txp666/MicroScope-Power/docs/open-source/hardware/挡板.step

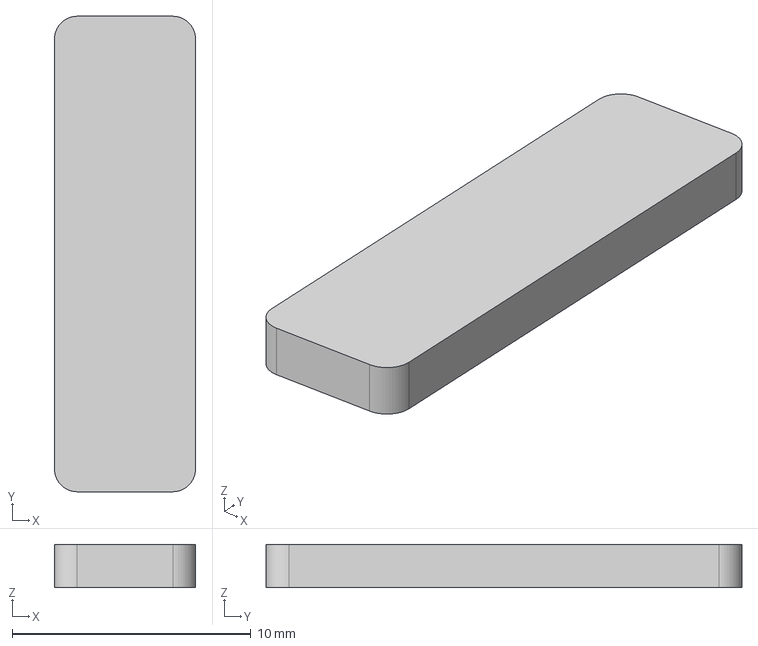
[picture p7: CAD file, 2026-10-14, last stored version]
docs/open-source/hardware/挡板.step
5.90 x 19.9 x 1.82 mm
