txp666/MicroScope-Power/docs/open-source/hardware/底壳.step

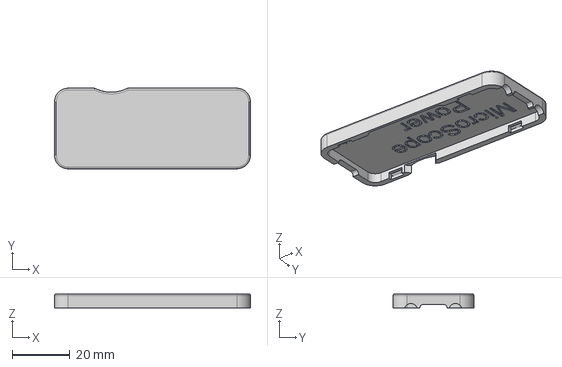
[picture p8: CAD file, 2026-10-14, last stored version]
docs/open-source/hardware/底壳.step
67.7 x 27.9 x 5.00 mm
