txp666/MicroScope-Power/docs/open-source/hardware/上盖.step

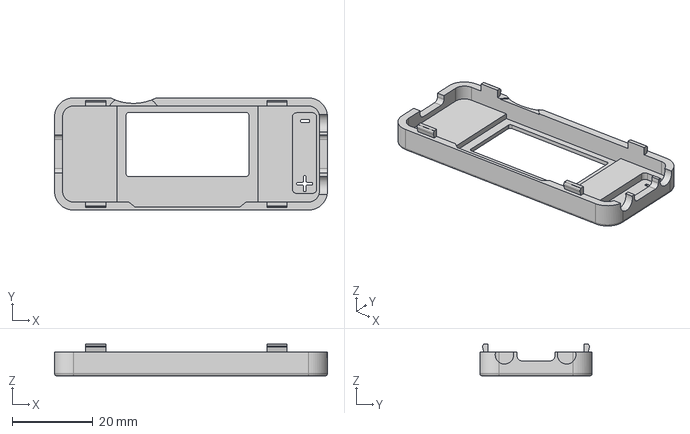
[picture p9: CAD file, 2026-10-14, last stored version]
docs/open-source/hardware/上盖.step
67.7 x 27.9 x 7.92 mm
