txp666/MicroScope-Power/docs/operation.md

# 使用说明

## 固件烧录

1. 构建固件：

   ```powershell
   powershell.exe -NoProfile -ExecutionPolicy Bypass -File .\scripts\build-firmware.ps1
   ```

2. 按住 Pico `BOOTSEL` 接入 USB。
3. 将 `build/firmware-ninja/pico_power_scope.uf2` 拷贝到 Pico 盘符。
4. Pico 自动重启后进入 WebUSB 设备模式。

已烧录过本固件后，可以不用按 BOOTSEL：

1. 打开 [modusignal 上位机](https://modusignal.cn/pages/devices/microscope-power/)并连接设备。
2. 点击顶部“固件升级”。
3. 确认后设备会停止采集并重启到 BOOTSEL/U盘模式。
4. 把新的 UF2 拷贝到 Pico 盘符。

也可以按住本地滚轮按键再上电，持续约 `1s` 后设备会直接进入 BOOTSEL/U盘模式。
这一路径只是免按键进入 ROM bootloader，不是边运行边写自身 flash 的网络 OTA。

## 发布版本

CI 会自动构建固件。普通 push/PR 只生成 Actions artifact；打 `v*` tag 会创建 GitHub Release 并上传固件资产。

```powershell
git tag v0.2.1
git push origin v0.2.1
```

固件中的版本字段来自 tag。网页连接设备后，“状态”卡片会显示固件版本。

## 打开上位机

使用 Chrome 或 Edge 打开 [modusignal 上位机](https://modusignal.cn/pages/devices/microscope-power/)，点击“连接设备”。上位机由 modusignal 统一维护，本仓库不再提供独立网页副本。

## 量程与电阻

当前有两个量程：

| 网页名称 | 固件 range | 默认电阻 | 说明 |
| --- | ---: | ---: | --- |
| 大量程 | `1` | `1Ω` | 较大电流，SEL=0 |
| 小量程 | `10` | `10Ω` | 较小电流，SEL=1 |

网页输入电阻单位是 `Ω`。点击“应用校准”后，上位机会下发：

```text
SET_SENSE_MOHM_RANGE 1 <大量程电阻mΩ>
SET_SENSE_MOHM_RANGE 10 <小量程电阻mΩ>
```

两个电阻值会保存到 Pico flash，断电后恢复。

## 归零

推荐流程：

1. 让输入处于零电流状态。
2. 根据需要选择自动量程或手动量程。
3. 先开始采集，收到当前量程的有效数据后点击“归零”。
4. 确认当前电流接近 `0 uA`。

注意：

- 两个量程有独立零点。
- 如果只在一个量程归零，切换到另一个量程时可能仍有偏移。
- 手动编辑零点偏移，单位为 `μA`，点击“应用校准”可写入指定量程零点；网页负责换算为设备使用的 ADC 零点值。
- 零点会保存到 Pico flash，断电后恢复。

## 自动量程

自动量程打开时：

- 默认优先从 1Ω 大量程开始采集。
- 大量程信号较小时会切到 10Ω 小量程。
- 小量程接近饱和或偏离零点过大时会切回 1Ω 大量程。
- 切换后会丢弃若干稳定帧，避免把切换瞬间显示成有效波形。
- 稳定期在时间轴上保留为空档，游标和 CSV 不会把这段时间压缩掉。

如果被测负载低功耗间歇工作，波形出现大幅跳变可能是负载本身的工作模式，不一定是通信问题。可先接固定电阻验证稳定性。

## 采样率

支持：

- `10 kSPS`
- `20 kSPS`
- `50 kSPS`
- `100 kSPS`

切换采样率需等待设备确认，并清空旧缓存开始新采集段，避免用新采样率解释旧数据。需要保留当前波形时，请先导出。

状态栏会显示 ADC 读取超时和时序超限计数，每两秒刷新。连续保留的样本按相邻帧时间戳估算间隔，时序超限本身不会让曲线每帧断线；真正丢帧或换档稳定期仍保留断点。标称采样率不等于已验证的实际采样率；尤其 100kSPS，应在目标板上测量 CONVST 周期、有效帧率和抖动。时序超限非零时，先降低采样率并检查硬件。

## 波形查看

常用控件：

- “清屏”：清除网页本地缓存，不影响固件。
- “暂停”：停止跟随最新数据，采集仍继续；点击“继续”恢复跟随。
- “包络”默认开启，像素桶保留所有样本的极值，窄脉冲不会因显示降采样而遗漏。均值、峰峰值和 RMS 噪声均基于窗口内全部有效采样；RMS 噪声是去除直流均值后的 AC RMS。
- “最新”：回到最新数据。
- “＋ / −”：调整时间窗口。
- “← / →”：查看历史缓存。
- 鼠标滚轮：在曲线上缩放。
- 左键拖框：同时放大时间轴和电流轴。
- 右键拖动：平移；双击恢复最新波形与自动 Y 轴。
- “显示设置”里的低通滤波：选择截止频率或自定义 Hz；曲线、游标、统计使用同一结果，原始 CSV 可独立导出。降低截止频率会衰减短脉冲并增加响应延迟。
- 自动 Y 轴：按当前可见窗口估计显示范围。
- 手动 Y 轴：取消自动 Y 轴后可固定上下限。

网页保留一段环形缓存，数据很多时绘图按列聚合 min/max，避免每个点都画导致卡顿。

## 电流单位

曲线、统计、游标、量程范围和零点偏移统一以 `μA` 显示。右侧 Y 轴同步换算为 `mA`，两轴表示同一电流范围。Y 轴手动上下限以 `μA` 输入，页面负责内部数据换算。

## OLED 本地显示

上位机没有开始采集时，OLED 显示：

- 输出电压，单位 `V`，两位小数显示。
- 当前电流，单位 `UA` / `MA` / `A`，均显示两位小数，例如 `12.34UA`。

电压行右侧小字显示当前旋钮步进，只显示数值，例如 `0.01`、`0.1`、`1`。
空闲显示约每 `200ms` 更新。电流由 core 1 在后台连续采样，使用最近 40 个已完成的 `50ms` 数据桶求约 2 秒滑动平均，保留短脉冲对平均电流的贡献。OLED 读取统计结果，再以 `1/4` 权重轻度平滑；变化不足 `0.05μA` 时保持当前显示，以减小末位跳动。电压仍以 `1/8` 权重平滑，旋钮调整 DAC 立即生效。
本地电流使用当前量程、电阻和零点。启动/停止上位机采集、切换量程或修改零点、电阻后重新积累窗口；窗口未就绪或读取异常时显示 `--.--UA`。上位机采集运行时暂停本地监测和 OLED 更新，ADS8866 由波形采集独占。
ADS8866 后台读取带超时保护，失败的样本不进入统计窗口。

### 本地电流归零

在确认输入处于零电流状态后，保持旋钮静止并长按按键约 `2s`，将当前量程的 2 秒平均 ADC 码设为零点。成功后显示 `ZERO OK` 并发出提示音，固件自动保存零点；另一量程的零点保持不变。归零后电流窗口重新积累约 2 秒。

若窗口尚未就绪、采样异常或量程正在切换，显示 `ZERO WAIT` 并发出低音提示，本次不修改零点；等读数恢复后重新长按。长按每次只触发一次，松开不会切换步进。按住旋转仍用于快速调压，并取消本次长按归零。上位机采集期间本地按键不处理；按住按键上电仍进入 BOOTSEL 模式。

## DAC 输出

本地旋钮用于调整 DAC 输出电压：

- 旋转：调整。
- 按住旋转：快速调整。
- 短按：切换步进。

常用步进为 `0.01 / 0.1 / 1 V`。按住旋转时使用快速倍率。
DAC 输出电压会在停止调节约 `1.5s` 后保存，断电后恢复。输出电压显示来自 ADC 实测值，因此可能和设定值略有差异。

## 断电保存

当前保存内容：

- 大量程零点。
- 小量程零点。
- 大量程采样电阻。
- 小量程采样电阻。
- DAC 输出电压。

保存写入 flash 最后一个扇区。采集运行时不写 flash，避免影响高速采样。
