txp666/MicroScope-Power/tests/xiao_nrf52840_sense_plus/images/capture.png

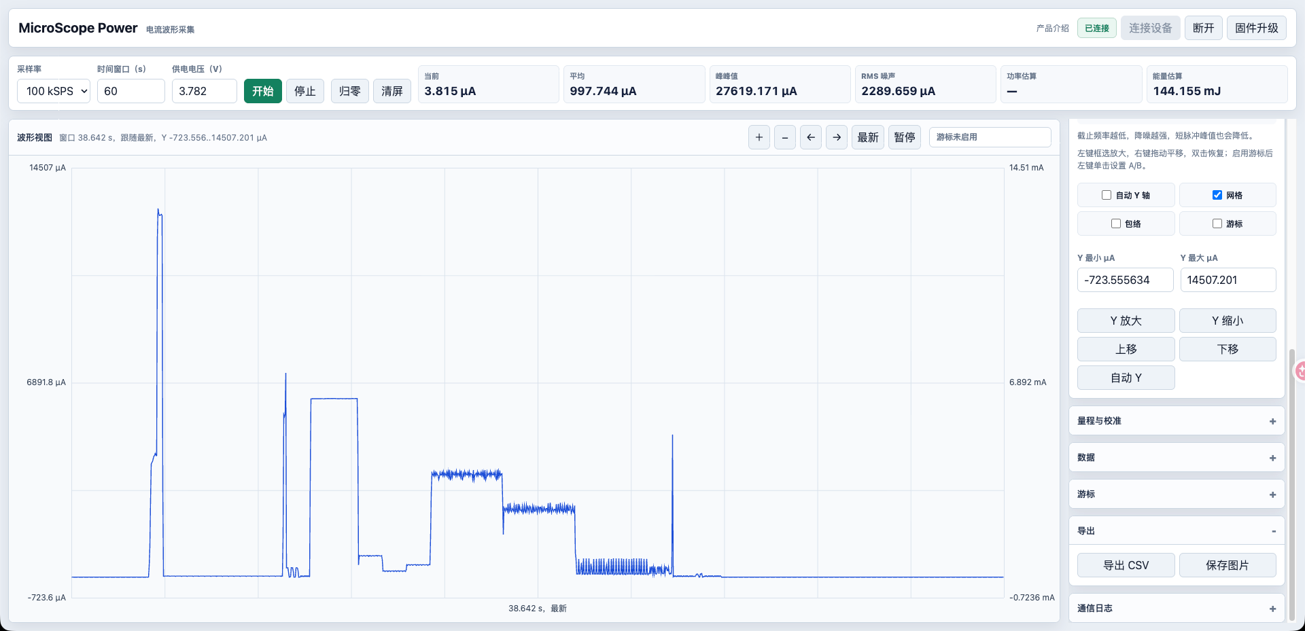
tests/xiao_nrf52840_sense_plus/images/capture.png
