txp666/MicroScope-Power/tests/xiao_nrf52840_sense_plus/images/flash-shutdown.png

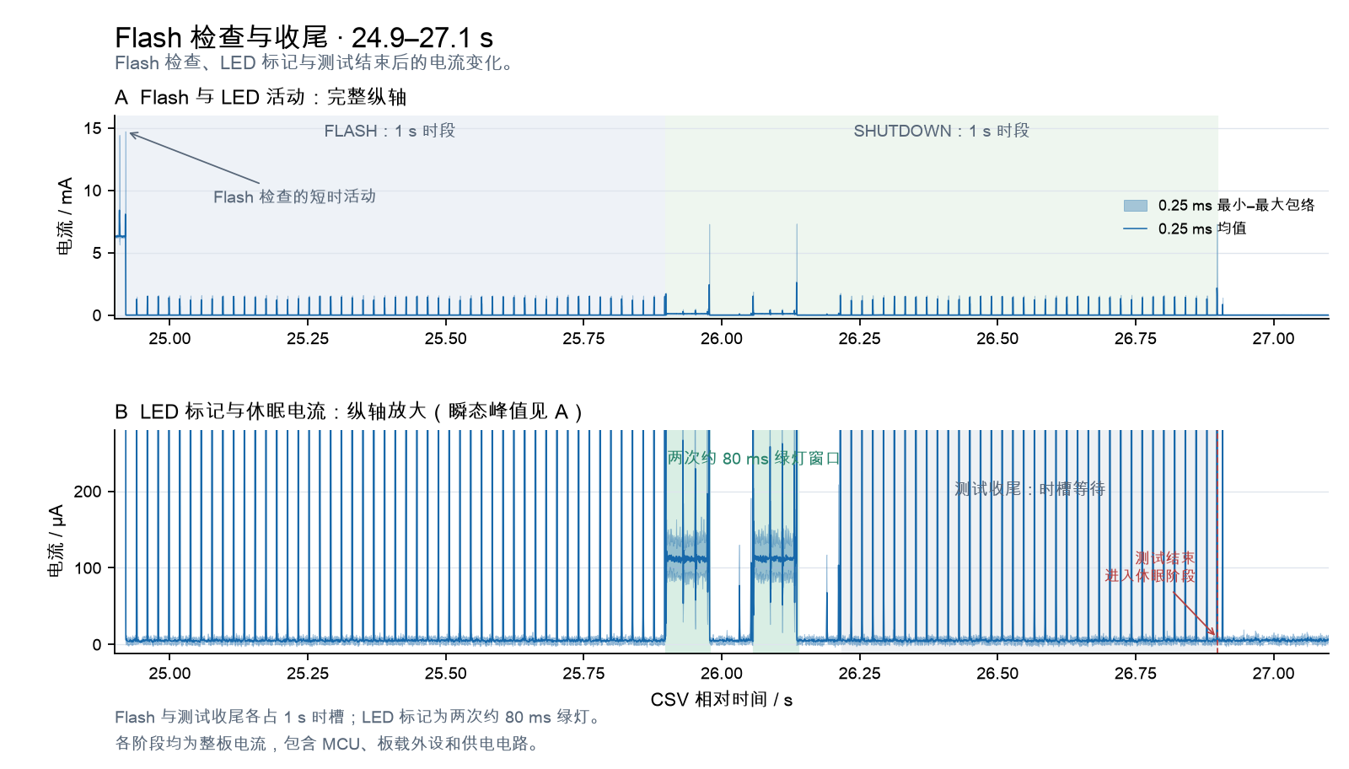
tests/xiao_nrf52840_sense_plus/images/flash-shutdown.png
