txp666/MicroScope-Power/tests/xiao_nrf52840_sense_plus/images/sleep-detail.png

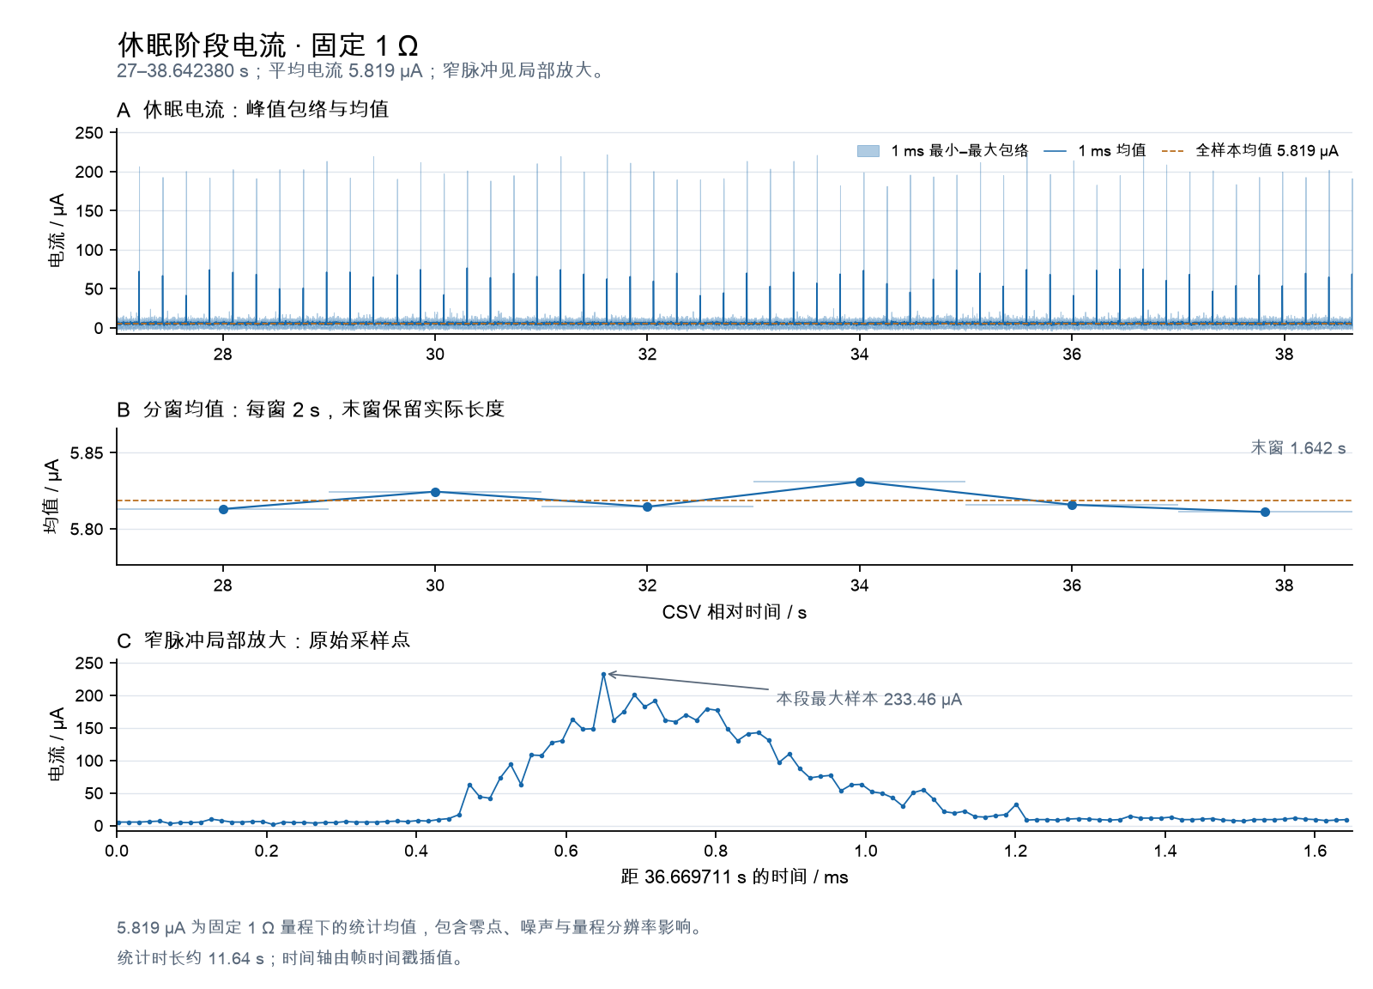
tests/xiao_nrf52840_sense_plus/images/sleep-detail.png
