txp666/MicroScope-Power/CHANGELOG.md

# 更新日志

## v0.2.3（2026-10-17）

- OLED 微安电流支持两位小数，使用 64 位和 Q8 定点运算保留平均 ADC 码与滤波过程中的小数精度。
- 空闲电流改为 core 1 后台连续采样，以 40 个 `50ms` 数据桶计算约 2 秒滑动均值，再做轻度平滑和 `0.05μA` 显示滞回，保留短脉冲对均流的贡献；窗口未就绪或失效时显示 `--.--UA`。
- 空闲时静止长按旋钮按键约 `2s`，以有效窗口均值对当前量程归零并自动保存；使用 `ZERO OK` / `ZERO WAIT` 和提示音反馈结果。
- 长按只触发一次，松开不切换步进；按住旋转保留快速调压并取消该次归零，初始化时已按住的按键需要释放后重新按下。
- 修复 OLED 短字符串显示越界读取；增加连续监测、归零、编码器事件及 CSV 回放验证，README 新增程序框架 PNG/SVG。
- 新增 XIAO nRF52840 Sense Plus 被测负载测试程序、工具和测量报告；该测试程序用于 XIAO，分析仪继续使用本发布的 Pico 固件。

固件交叉编译和主机回归测试通过；新增本地显示、长按和保存行为尚未完成实板验证。

## v0.2.1（2026-10-14）

- 项目自有材料改用 MIT 许可证，保留第三方组件的原始许可，并随固件发布提供许可文件。
- README 新增整机、PCB/OLED/外壳及上位机截图，优化图片体积；上位机由 ModuSignal v1.0.4 提供可选截止频率低通、左键框选和右键平移。
- 蜂鸣器停止时强制将驱动 GPIO 拉低，避免 PWM 停在高电平后让电磁线圈持续通电；提示音重新启动时才恢复 PWM 输出，并修复停止时间恰好回绕为零时无法停止的问题。
- 移除固件仓库中的上位机副本及网页测试，统一由 modusignal 维护；使用说明改为 modusignal 入口，固件 CI 保留主机测试和交叉编译。
- 修复连续采样因帧间时序延迟而每 256 点断线：按相邻帧起点估算帧内间隔，区分时序超限与真正的数据缺口，并兼容旧固件的时序标记。
- 修复 Flash 擦写缺少本核中断保护，并校验回读参数与保存请求一致。
- 修复双核采集启停及自动量程计数下溢，接近零电流时允许进入高灵敏度档。
- SPI 超时不再重复上次 ADC 值；增加读取错误和采样时序超限统计。
- 保持 530 字节帧格式，增加采集段起点/时间缺口标志；网页保留时间戳回绕和换档空档。
- 完善 WebUSB 拆包、命令应答、响应排队与重连清理；操作失败不再误报成功。
- 使用分块统计索引保留所有采样点的极值、均值和 AC RMS，缓存静态窗口并默认显示精确包络。
- 增加固件主机回归测试并纳入 CI；网页回归测试移至 modusignal，电压输出仍使用原 DAC/LDO 设定方式。

## v0.2.0

- 增加 3 秒 OLED 开机动画和短提示音。
- 支持按住本地滚轮按键上电进入 BOOTSEL/U盘模式。
- OLED 主屏输出电压改为两位小数显示，电压行右侧显示当前步进数值。
- 本地 DAC 调节步进改为 `0.01 / 0.1 / 1 V`。
- 优化滚轮处理：取消 GPIO 中断，改为轮询 A 相并读取 B 相判断方向，降低卡死风险。
- ADS8866 SPI 本地读取增加超时保护，避免空闲 OLED 显示路径永久阻塞。
- 调整初始化顺序，先初始化采样模块，再进入本地 UI 首屏。

## v0.1.0

- 初始发布版本。
- ADS8866 真实采样和 WebUSB 二进制上传。
- 上位机波形显示、双坐标轴、量程校准、归零、导出。
- BOOTSEL/U盘模式固件升级入口。
- GitHub Actions 自动构建固件并上传 Release assets。
