txp666/MicroScope-Power/(commit log)

2026-07-08 Add support for firmware upgrade via BOOTSEL mode
    - Updated README.md to include instructions for entering BOOTSEL mode for firmware upgrades.
    - Enhanced operation.md with steps for upgrading firmware without pressing the BOOTSEL button.
    - Modified protocol.md to define new commands: BOOTSEL, OTA, and REBOOT_BOOTSEL for firmware upgrades.
    - Implemented firmware changes to handle BOOTSEL command and trigger USB bootloader.
    - Added UI elements in app.js and index.html for initiating firmware upgrades from the web interface.
    [main.c]
2026-10-14 Release v0.2.1: stabilize acquisition and stop idle buzzer current
    Keep the WebUSB host in ModuSignal, add device photos and operation guidance, and license project materials under MIT with third-party notices.
    [ads8866.c, ads8866.h, app_settings.c, buzzer.c]
2026-10-14 docs: add open-source article, diagrams and hardware materials
    [components.csv, 上盖.step, 底壳.step, 挡板.step]
2026-10-14 feat: report measured output voltage during capture
2026-10-14 docs: keep project publishing materials local
    [components.csv, 上盖.step, 底壳.step, 挡板.step]
2026-10-15 test: add XIAO Sense Plus power measurement suite and report
2026-10-17 feat: stabilize OLED current and add long-press zeroing
    [encoder.c, encoder.h, local_ui.c, local_ui.h, main.c, oled_ssd1306.c, replay_local_current.py, sampler.c]
